LV-ZHU/OLED_MPE_PLAYER/README.md

# OLED_MPE_PLAYER
数字逻辑大作业，参考https://github.com/DinoMax00/TJ-FPGA_MP3 实现
